jarifalamclaude-max/torpedo-driver-circuit/pcb-3d/tex_bot.jpg

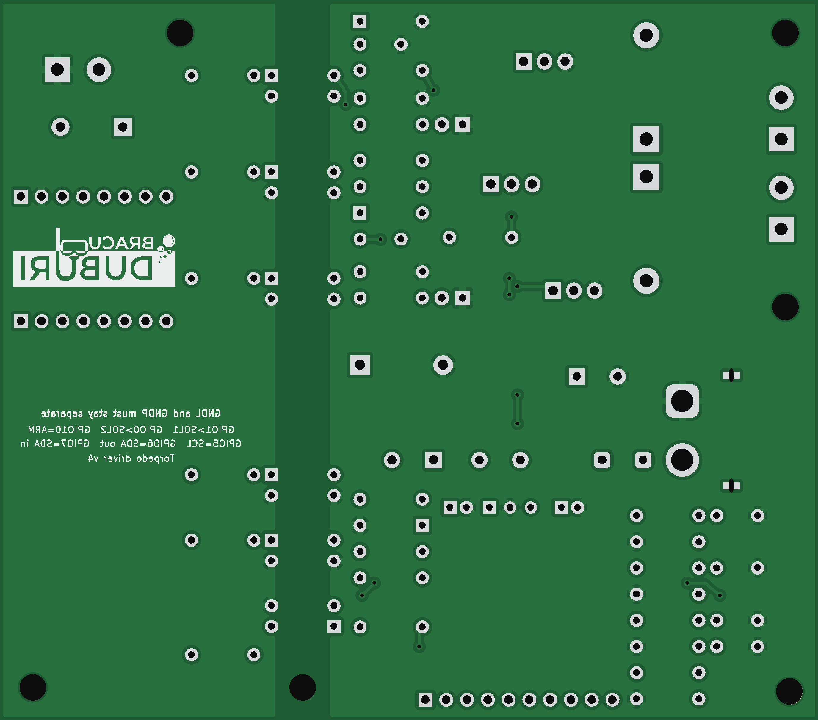
pcb-3d/tex_bot.jpg
