jarifalamclaude-max/torpedo-driver-circuit/pcb-3d/tex_top.jpg

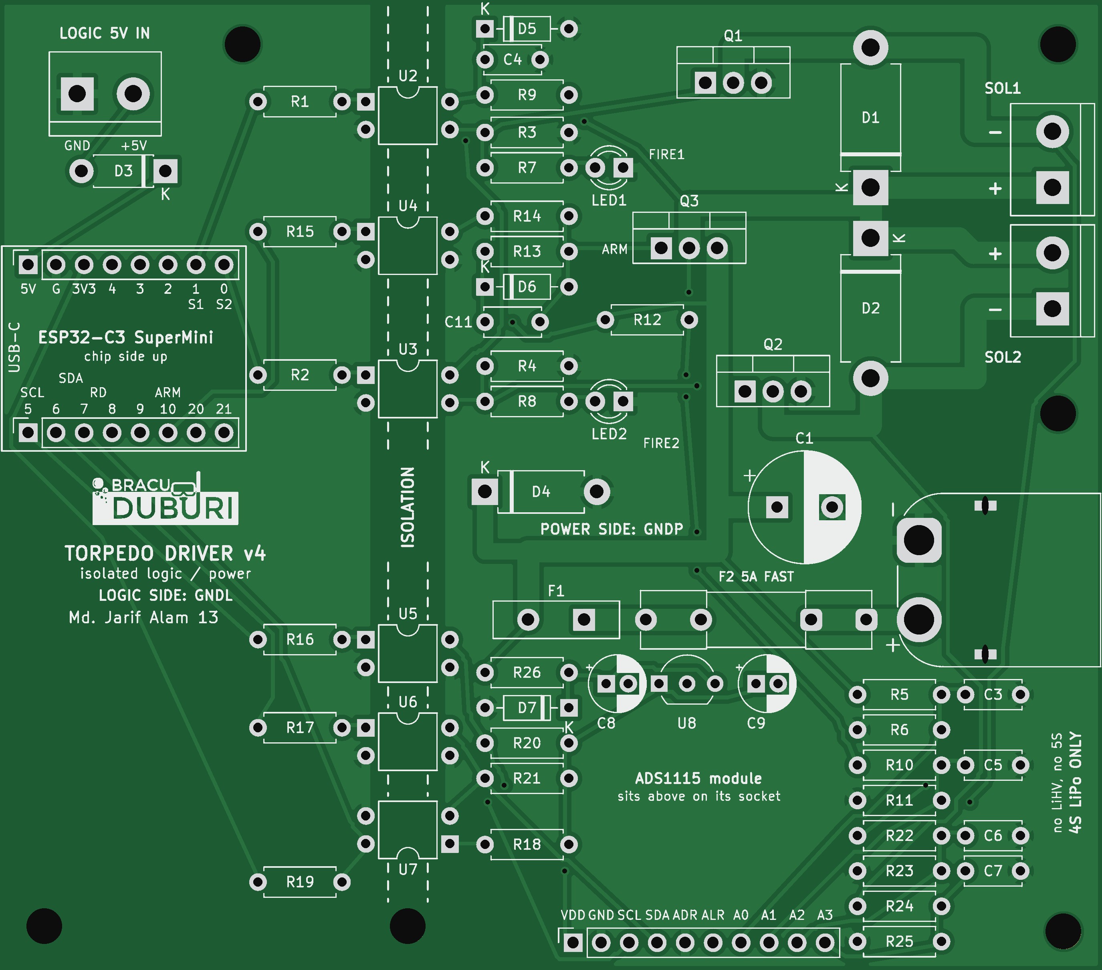
pcb-3d/tex_top.jpg
