jarifalamclaude-max/torpedo-driver-circuit/kicad/torpedo_driver_v4.kicad_pcb

## KiCad design kicad/torpedo_driver_v4.kicad_pcb (2026-11-12)

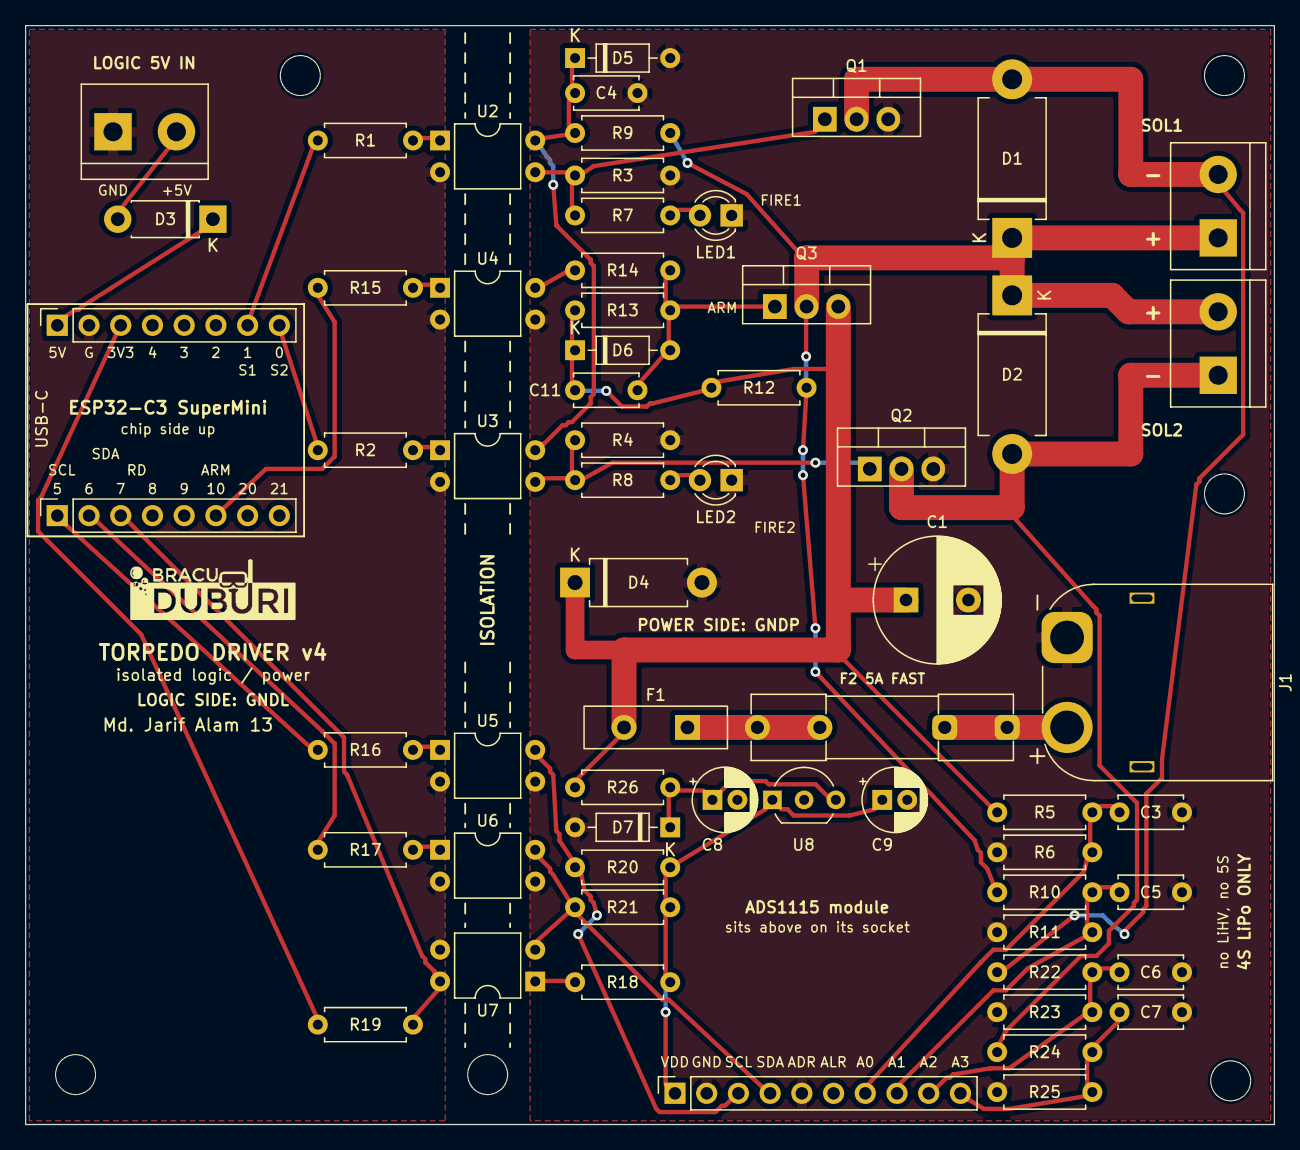
[picture p3: board torpedo_driver_v4.kicad_pcb from above]

Board: 2 copper layers, 100.0 x 88.0 mm, 69 parts (0 on the bottom side), 38 nets.

Parts:
C1: 470uF 35V; CP_Radial_D10.0mm_P5.00mm
C3, C4, C5, C6, C7, C11: 100nF; C_Disc_D5.0mm_W2.5mm_P5.00mm
C8, C9: 10uF 35V; CP_Radial_D5.0mm_P2.00mm
D1, D2: UF5408; D_DO-201AD_P12.70mm_Horizontal
D3: 1N5819; D_DO-41_SOD81_P7.62mm_Horizontal
D4: P6KE22A; D_DO-15_P10.16mm_Horizontal
D5: 12V zener; D_DO-35_SOD27_P7.62mm_Horizontal
D6: 15V zener; D_DO-35_SOD27_P7.62mm_Horizontal
D7: 20V zener; D_DO-35_SOD27_P7.62mm_Horizontal
F1: RUEF300 PTC 3A 30V; PTC_Radial_P5.08mm_W11.5mm
F2: 5A fast 5x20 ceramic; Fuseholder_Clip-5x20mm_Littelfuse_111_Inline_P20.00x5.00mm_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
H1, H2, H3, H4, H5, H6: M3; MountingHole_3.2mm_M3
J1: XT60PW-M; AMASS_XT60PW-M_1x02_P7.20mm_Horizontal
J2: SOL1; TerminalBlock_bornier-2_P5.08mm
J3: SOL2; TerminalBlock_bornier-2_P5.08mm
J4: LOGIC 5V IN; TerminalBlock_bornier-2_P5.08mm
LED1, LED2: red 3mm; LED_D3.0mm
Q1, Q2: IRLZ44N; TO-220-3_Vertical
Q3: IRF4905; TO-220-3_Vertical
R1, R2, R15: 150; R_Axial_DIN0207_L6.3mm_D2.5mm_P7.62mm_Horizontal
R3, R4, R13: 4.7k; R_Axial_DIN0207_L6.3mm_D2.5mm_P7.62mm_Horizontal
R5, R10, R22, R24: 200k 1%; R_Axial_DIN0207_L6.3mm_D2.5mm_P7.62mm_Horizontal
R6, R11, R23, R25: 20k 1%; R_Axial_DIN0207_L6.3mm_D2.5mm_P7.62mm_Horizontal
R7, R8, R20, R21: 10k; R_Axial_DIN0207_L6.3mm_D2.5mm_P7.62mm_Horizontal
R9: 680; R_Axial_DIN0207_L6.3mm_D2.5mm_P7.62mm_Horizontal
R12: 68k 1%; R_Axial_DIN0207_L6.3mm_D2.5mm_P7.62mm_Horizontal
R14, R18, R26: 1k; R_Axial_DIN0207_L6.3mm_D2.5mm_P7.62mm_Horizontal
R16, R17: 220; R_Axial_DIN0207_L6.3mm_D2.5mm_P7.62mm_Horizontal
R19: 6.8k; R_Axial_DIN0207_L6.3mm_D2.5mm_P7.62mm_Horizontal
U1A: SuperMini 5V..IO0; PinSocket_1x08_P2.54mm_Vertical
U1B: SuperMini IO5..IO21; PinSocket_1x08_P2.54mm_Vertical
U2, U3, U4, U5, U6, U7: PC817; DIP-4_W7.62mm
U8: LP2950-3.3; TO-92_Inline_Wide
U9: ADS1115 module (GY-ADS1115); PinSocket_1x10_P2.54mm_Vertical

Connections:
3V3L: R19.1, U1A.3
3V3P: C9.1, R18.1, R20.2, R21.2, U8.1, U9.1
5V_IN: D3.2, J4.2
+5V: D3.1, U1A.1
ARM: R15.1, U1B.6
D1N: D1.2, J2.2, Q1.2, R22.1
D2N: D2.2, J3.1, Q2.2, R24.1
FIRE1: R1.1, U1A.7
FIRE2: R2.1, U1A.8
G1: Q1.1, R3.1, R7.1, U2.3
G2: Q2.1, R4.1, R8.1, U3.3
G3: C11.2, D6.2, Q3.1, R13.2, R14.2
G3D: R14.1, U4.4
GNDL: J4.1, U1A.2, U2.2, U3.2, U4.2, U5.2, U6.2, U7.3
GNDP: C1.2, C3.2, C4.2, C5.2, C6.2, C7.2, C8.2, C9.2, D4.2, D5.2, D7.2, J1.1, LED1.1, LED2.1, Q1.3, Q2.3, R3.2, R4.2, R6.1, R11.1, R23.1, R25.1, U4.3, U5.3, U6.3, U8.2, U9.2, U9.5
LED1A: LED1.2, R7.2
LED2A: LED2.2, R8.2
OL1: R1.2, U2.1
OL2: R2.2, U3.1
OL3: R15.2, U4.1
OSCL: R16.2, U5.1
OSDA: R17.2, U6.1
SBAT: C3.1, R5.2, R6.2, U9.7
SCL_P: R20.1, U5.4, U9.3
SCL_TX: R16.1, U1B.1
SD1: C6.1, R22.2, R23.2, U9.9
SD2: C7.1, R24.2, R25.2, U9.10
SDA_P: R21.1, U6.4, U7.2, U9.4
SDA_RX: R19.2, U1B.3, U7.4
SDA_TX: R17.1, U1B.2
SSW: C5.1, R10.2, R11.2, U9.8
U7A: R18.2, U7.1
VBAT: C1.1, C11.1, D4.1, D6.1, F1.2, Q3.3, R5.1, R12.1, R13.1, R26.1
VBAT_IN: F2.1, J1.2
VFUSE: F1.1, F2.2
VG: C4.1, D5.1, R9.1, U2.4, U3.4
VPRE: C8.1, D7.1, R26.2, U8.3
VSW: D1.1, D2.1, J2.1, J3.2, Q3.2, R9.2, R10.1, R12.2
