jarifalamclaude-max/torpedo-driver-circuit/(commit log)

2026-11-11 Add torpedo driver v3: KiCad project, Gerbers, veroboard layout and schematic
    Claude-Session: https://claude.ai/code/session_01L6HZDsBGh4q8NrovXKm81C
    [torpedo_driver_v3-B_Cu.gbl, torpedo_driver_v3-B_Mask.gbs, torpedo_driver_v3-B_Silkscreen.gbo, torpedo_driver_v3-Edge_Cuts.gm1, torpedo_driver_v3-F_Cu.gtl, torpedo_driver_v3-F_Mask.gts, torpedo_driver_v3-F_Silkscreen.gto, torpedo_driver_v3-NPTH.drl]
2026-11-11 Add PCB 3D viewer
    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
2026-11-11 Add BRACU Duburi logo and designer name to the silkscreen
    Logo on front and back silkscreen, name on the front. Only the two
    silkscreen Gerbers changed; copper, mask, outline and drill files are
    identical to before.
    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
    [torpedo_driver_v3.kicad_pcb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]
2026-11-11 Remove local KiCad preferences file
    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
2026-11-11 Add KiCad project zip
    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
2026-11-11 Add simulation-ready KiCad schematic
    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
    [torpedo_driver_v3_sim.kicad_sch]
2026-11-12 Torpedo driver v4: isolated logic side, opto I2C sensing, all review fixes
    - Split GNDL / GNDP with a copper-free isolation channel; all six signals
    cross through PC817s, sensing moved to an ADS1115 on the battery side
    - Add 5 A fast ceramic fuse ahead of the PTC; P6KE22A TVS
    - Q3: 1k gate drive, 15 V gate clamp, 100 nF hot-plug cap
    - 150 R opto drive, 680 R gate rail, UF5408 flyback, 68k self-test bleed
    - New board (100 x 88 mm), own grid router, DRC 0/0/0, gerbers and zips
    - ngspice board simulation with fitted MOSFET and electromechanical
    solenoid models; opto I2C timing corners
    - ESP32-C3 firmware: hardware-timer pulses, watchdog, self-test, arm window
    - Simulation schematic, veroboa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
    [bom_v4.csv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]
